SemKirkels/Project_Ontwerpen/Afbeeldingen/PCB design.jpg

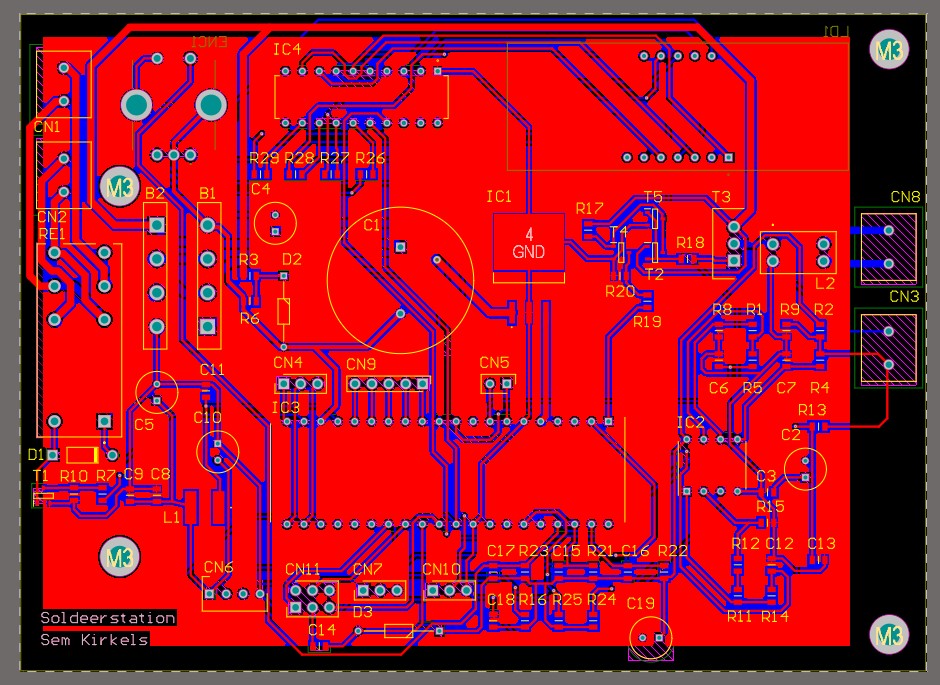
Afbeeldingen/PCB design.jpg
