SemKirkels/Project_Ontwerpen/Afbeeldingen/Solderingstation render 4.jpg

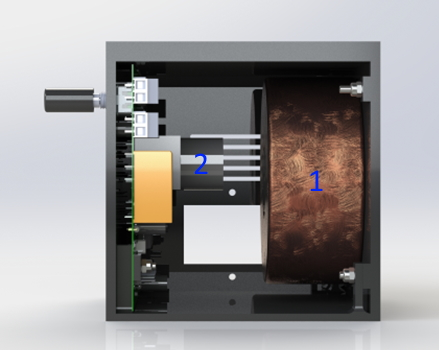
Afbeeldingen/Solderingstation render 4.jpg
