SemKirkels/Project_Ontwerpen/README.md

# Project_Ontwerpen

## Afbeeldingen
In de map afbeeldingen staan foto's en renders. Deze hebben een hoge resolutie en zijn niet volledig zichtbaar op github.
