SemKirkels/Project_Ontwerpen/Afbeeldingen/Connector_Pinout.jpeg

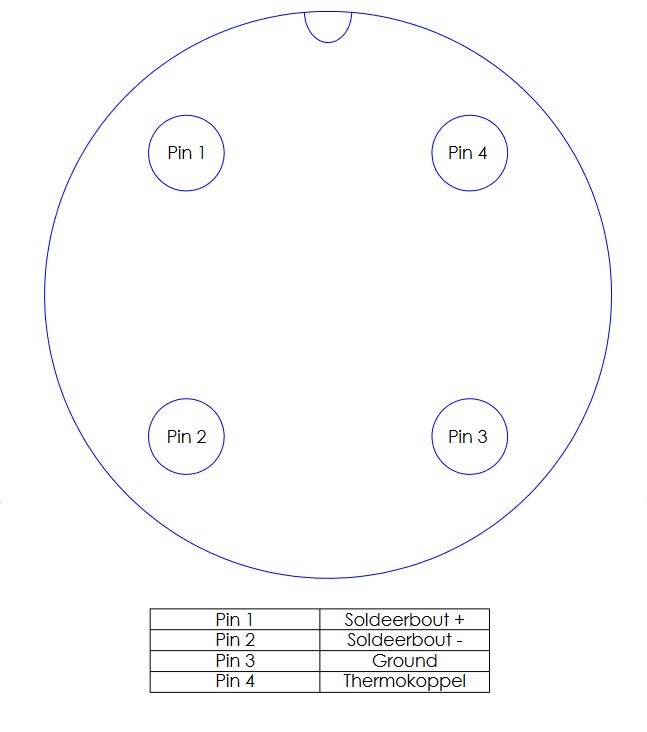
Afbeeldingen/Connector_Pinout.jpeg
