SemKirkels/Project_Ontwerpen/Case_Design/SolidWorks_Files/21P001S01-01.SLDPRT

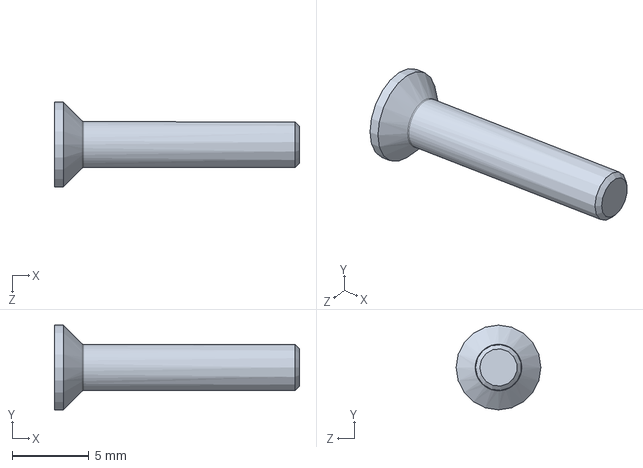
[picture p4: CAD file, 2022-06-03]
Case_Design/SolidWorks_Files/21P001S01-01.SLDPRT
16.0 x 5.54 x 5.54 mm
