SemKirkels/Project_Ontwerpen/Case_Design/SolidWorks_Files/21P001S01D05.SLDPRT

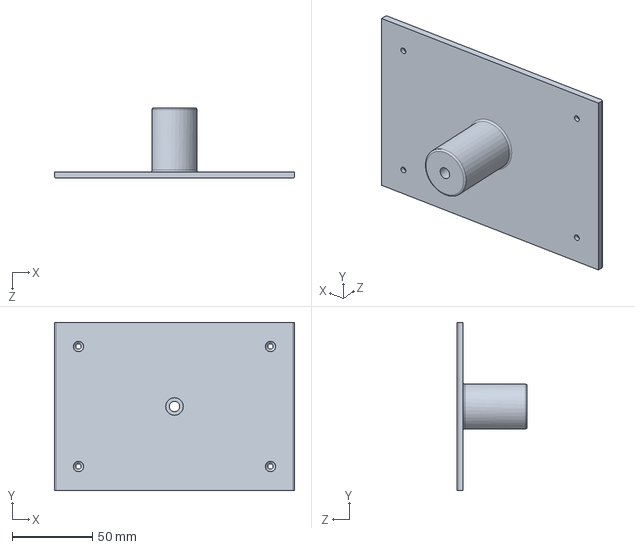
[picture p5: CAD file, 2022-06-03]
Case_Design/SolidWorks_Files/21P001S01D05.SLDPRT
150.0 x 105.0 x 44.0 mm
