SemKirkels/Project_Ontwerpen/Case_Design/SolidWorks_Files/21P001S01S01D01.SLDPRT

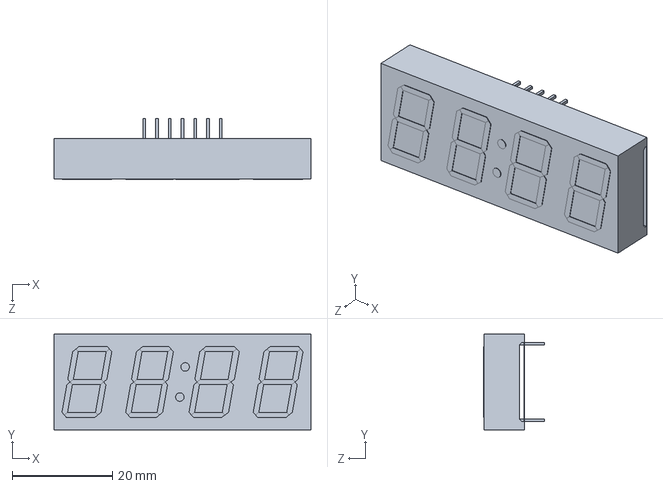
[picture p6: CAD file, 2022-06-03]
Case_Design/SolidWorks_Files/21P001S01S01D01.SLDPRT
51.2 x 19.1 x 12.1 mm
