SemKirkels/Project_Ontwerpen/Case_Design/SolidWorks_Files/21P001S01-02.SLDPRT

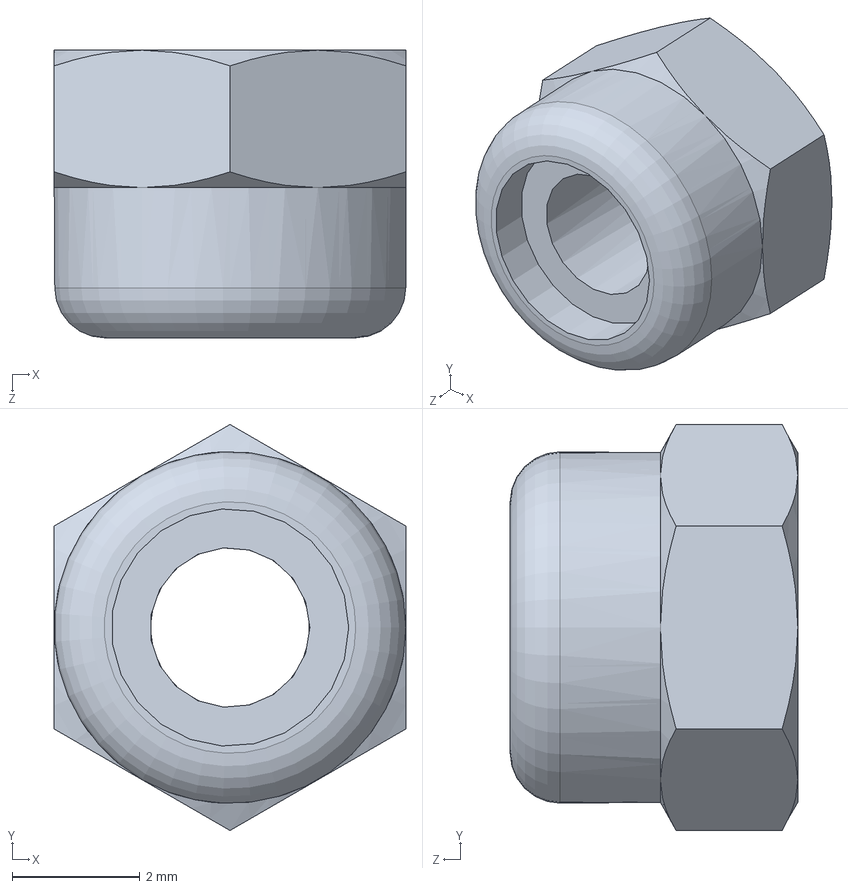
[picture p7: CAD file, 2022-06-03]
Case_Design/SolidWorks_Files/21P001S01-02.SLDPRT
5.50 x 6.35 x 4.50 mm
