SemKirkels/Project_Ontwerpen/Case_Design/SolidWorks_Files/21P001S01D04.SLDPRT

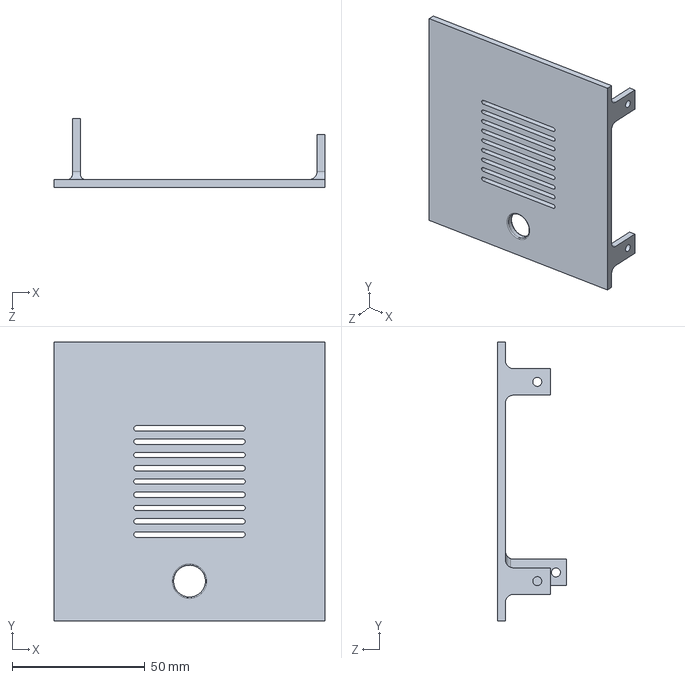
[picture p8: CAD file, 2022-06-03]
Case_Design/SolidWorks_Files/21P001S01D04.SLDPRT
102.0 x 105.0 x 26.0 mm
