SemKirkels/Project_Ontwerpen/Case_Design/SolidWorks_Files/21P001S01D06.SLDPRT

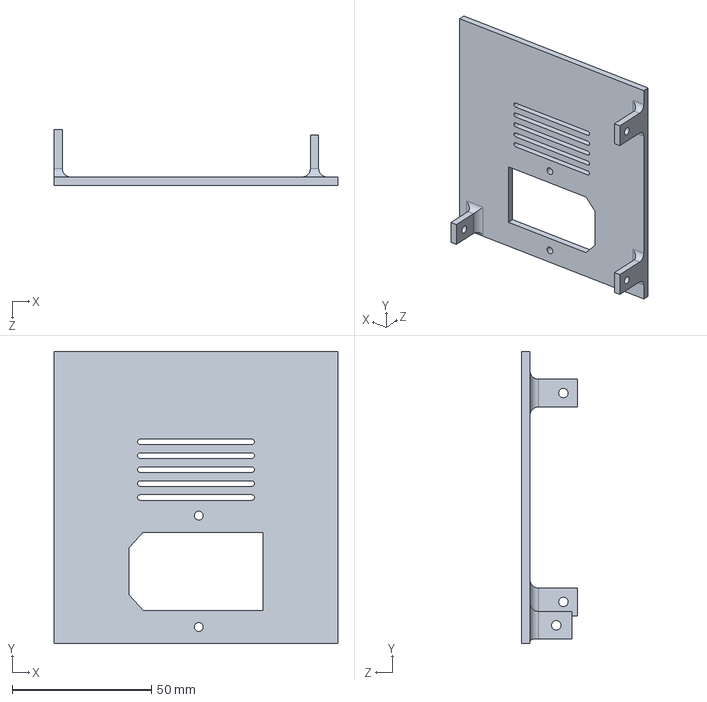
[picture p9: CAD file, 2022-06-03]
Case_Design/SolidWorks_Files/21P001S01D06.SLDPRT
102.0 x 105.0 x 20.0 mm
