SemKirkels/Project_Ontwerpen/Case_Design/SolidWorks_Files/21P001S01D02.SLDPRT

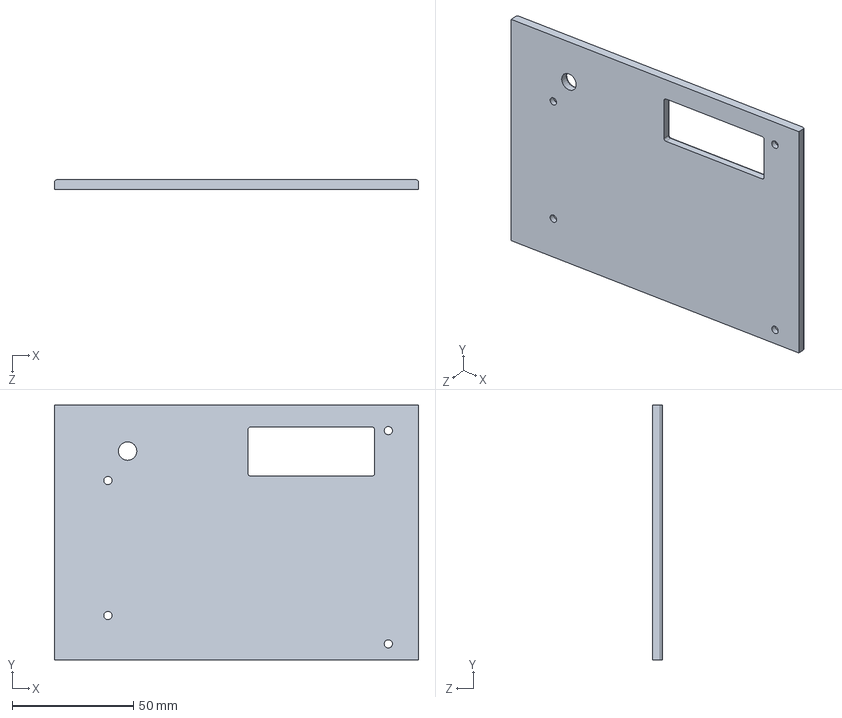
[picture p10: CAD file, 2022-06-03]
Case_Design/SolidWorks_Files/21P001S01D02.SLDPRT
150.0 x 105.0 x 4.00 mm
