SemKirkels/Project_Ontwerpen/Case_Design/SolidWorks_Files/21P001S01-03.SLDPRT

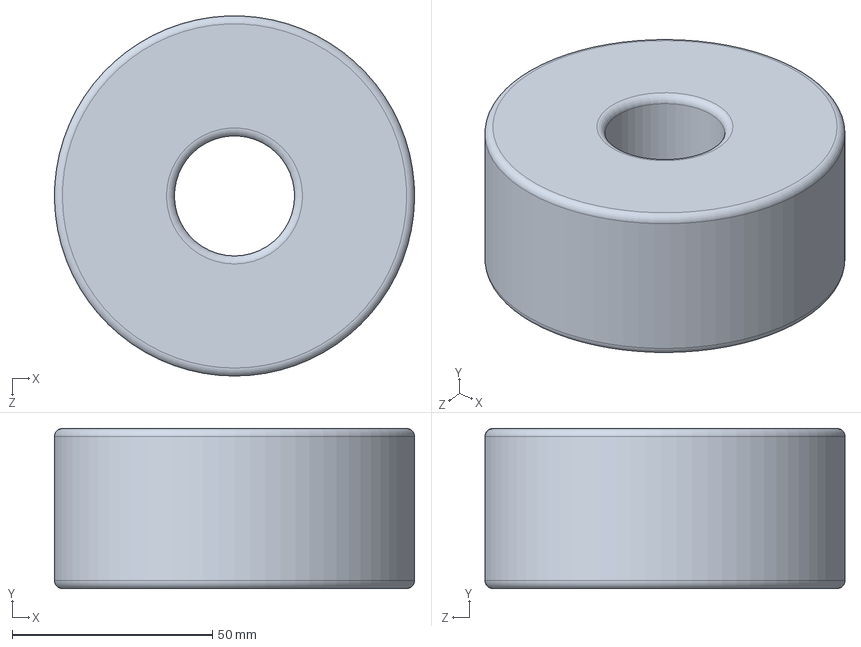
[picture p11: CAD file, 2022-06-03]
Case_Design/SolidWorks_Files/21P001S01-03.SLDPRT
90.0 x 40.0 x 90.0 mm
