SemKirkels/Project_Ontwerpen/Case_Design/SolidWorks_Files/21P001S01-04.SLDPRT

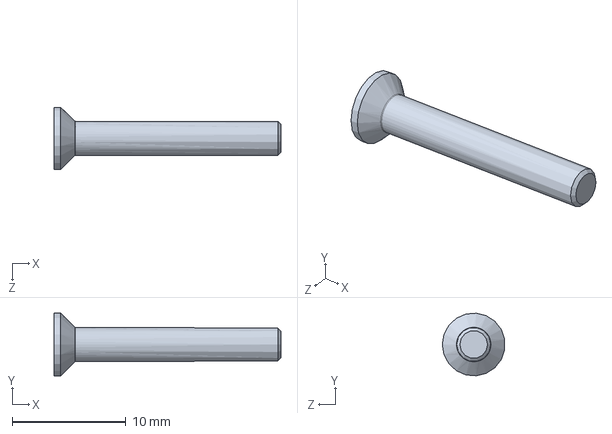
[picture p12: CAD file, 2022-06-03]
Case_Design/SolidWorks_Files/21P001S01-04.SLDPRT
20.0 x 5.52 x 5.50 mm
