SemKirkels/Project_Ontwerpen/Case_Design/SolidWorks_Files/21P001S01D07.SLDPRT

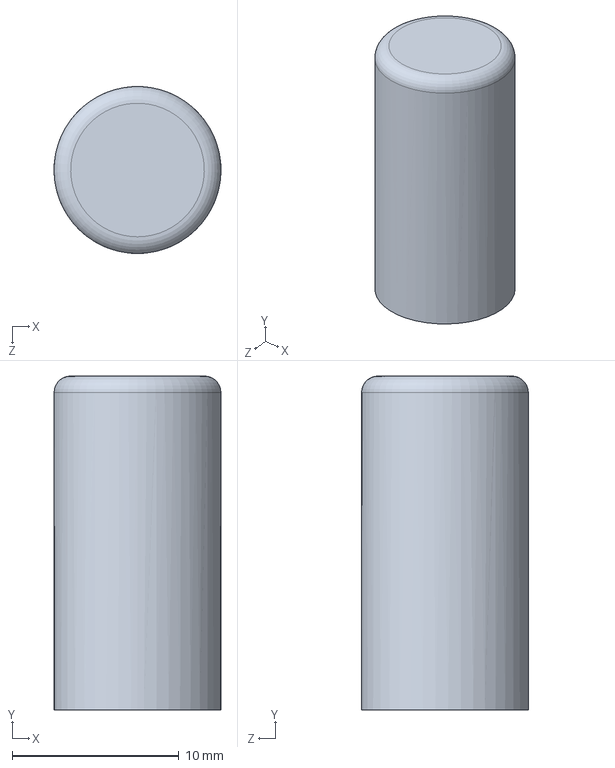
[picture p13: CAD file, 2022-06-03]
Case_Design/SolidWorks_Files/21P001S01D07.SLDPRT
10.00 x 20.0 x 10.0 mm
