SemKirkels/Project_Ontwerpen/Case_Design/SolidWorks_Files/21P001S01D03.SLDPRT

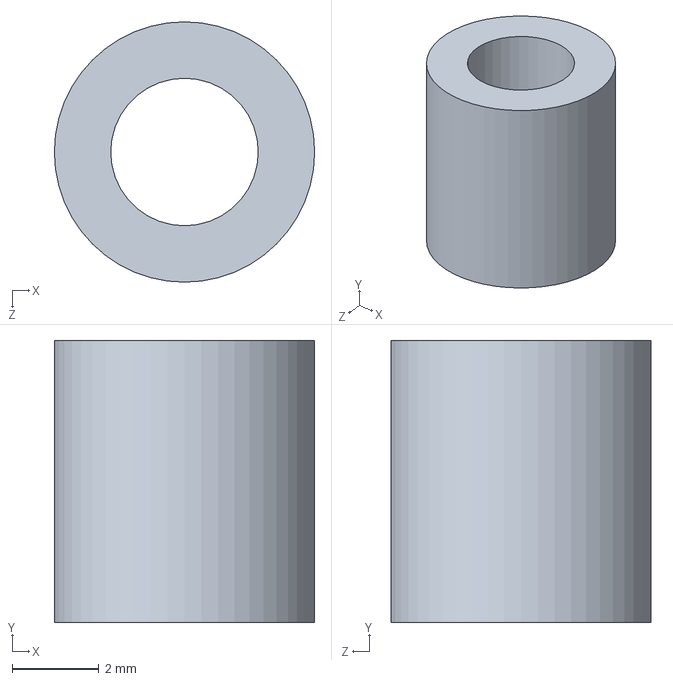
[picture p14: CAD file, 2022-06-03]
Case_Design/SolidWorks_Files/21P001S01D03.SLDPRT
6.00 x 6.50 x 6.00 mm
