SemKirkels/Project_Ontwerpen/Case_Design/SolidWorks_Files/21P001S01D08.SLDPRT

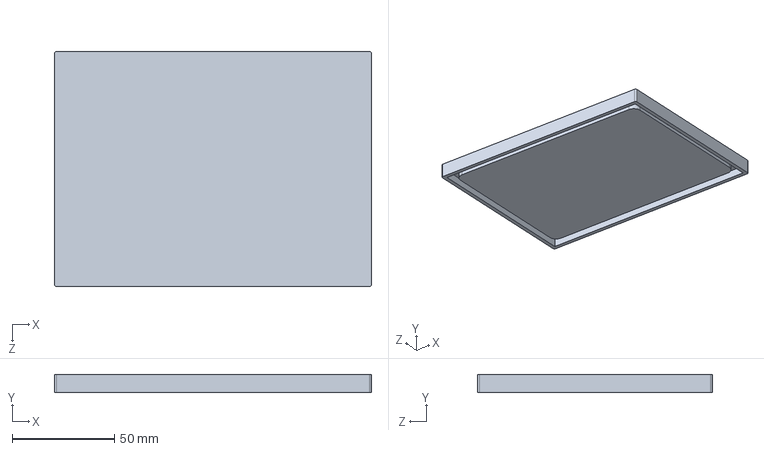
[picture p15: CAD file, 2022-06-03]
Case_Design/SolidWorks_Files/21P001S01D08.SLDPRT
155.0 x 9.00 x 115.0 mm
