SemKirkels/Project_Ontwerpen/Case_Design/SolidWorks_Files/21P001S01D01.SLDPRT

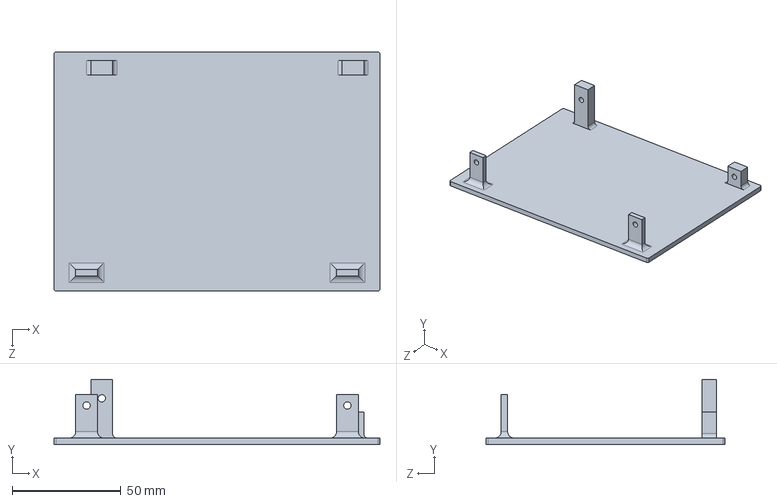
[picture p16: CAD file, 2022-06-03]
Case_Design/SolidWorks_Files/21P001S01D01.SLDPRT
150.0 x 30.0 x 110.0 mm
