SemKirkels/Project_Ontwerpen/(list of files, cad)

Other CAD files:
Case_Design/STL_Files/21P001S01D01.STL
Case_Design/STL_Files/21P001S01D02.STL
Case_Design/STL_Files/21P001S01D03.STL
Case_Design/STL_Files/21P001S01D04.STL
Case_Design/STL_Files/21P001S01D05.STL
Case_Design/STL_Files/21P001S01D06.STL
Case_Design/STL_Files/21P001S01D07.STL
Case_Design/STL_Files/21P001S01D08.STL
