SemKirkels/Project_Ontwerpen/(list of files, drawings)

Other design files:
PCB_Design/CPU.SchDoc
PCB_Design/Display.SchDoc
PCB_Design/PCB1.PcbDoc
PCB_Design/PcbLib1.PcbLib
PCB_Design/Project_Soldeerbout.PrjPcb
PCB_Design/Regelaar.SchDoc
PCB_Design/Schlib1.SchLib
PCB_Design/Versterker.SchDoc
PCB_Design/Voeding_Soldeerbout.SchDoc
