SemKirkels/Project_Ontwerpen/Afbeeldingen/Solderingstation render 2.JPG

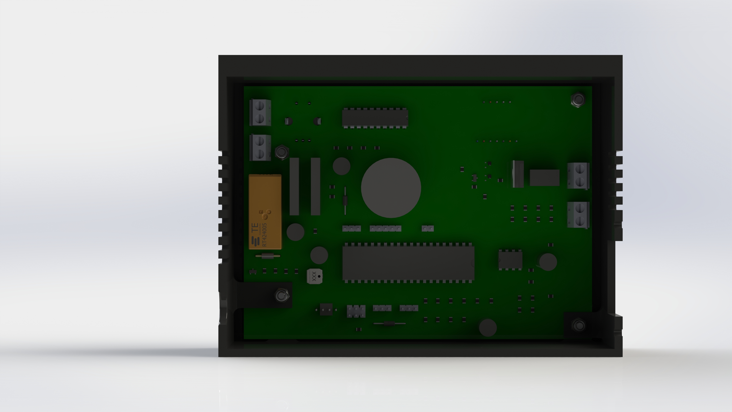
Afbeeldingen/Solderingstation render 2.JPG
