SemKirkels/Project_Ontwerpen/Afbeeldingen/Solderingstation render 3.JPG

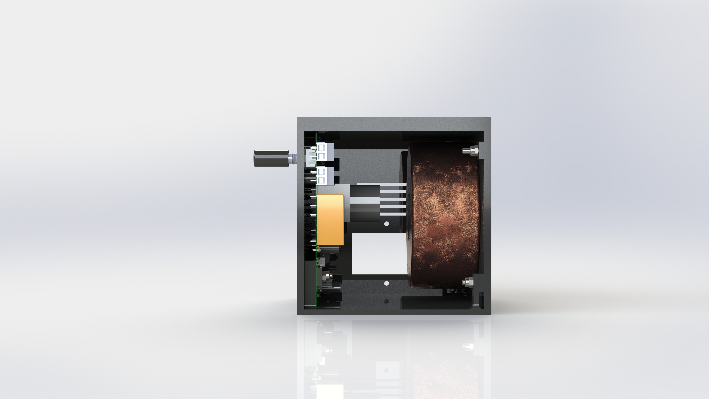
Afbeeldingen/Solderingstation render 3.JPG
