SemKirkels/Project_Ontwerpen/Afbeeldingen/Solderingstation render.JPG

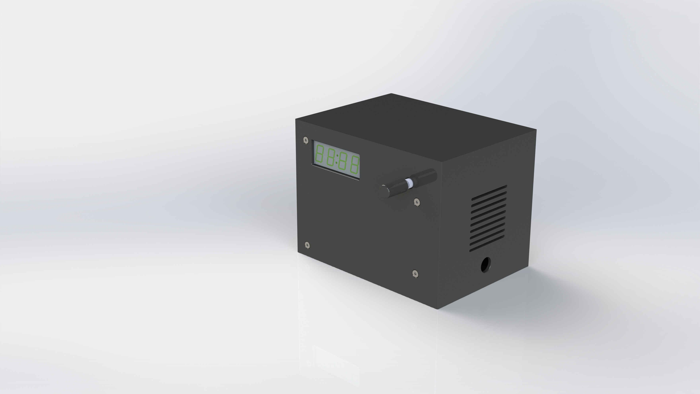
Afbeeldingen/Solderingstation render.JPG
