SemKirkels/Project_Ontwerpen/(commit log)

2022-05-06 Upload Project soldeerstation
    Upload soldeerstation
    [CPU.SchDoc, Display.SchDoc, PCB1.PcbDoc, PcbLib1.PcbLib, Project_Soldeerbout.PrjPcb, Regelaar.SchDoc, Schlib1.SchLib, Versterker.SchDoc]
2022-06-03 Upload Project
    [21P001S01-01.SLDPRT, 21P001S01-02.SLDPRT, 21P001S01-03.SLDPRT, 21P001S01-04.SLDPRT, 21P001S01D01.SLDPRT, 21P001S01D01.STL, 21P001S01D02.SLDPRT, 21P001S01D02.STL]
2022-06-11 Create Connector_Pinout.jpeg
    Pinout van de connector toegevoegd
